ihsan-sa/USB-C-Trigger-Board/Gen1_trigger_boards/USB_C_Trig_Board_Simple_Multi_Layer/USB_C_Simple_Trig_Multi_Layer/3D models/USB4056-03-A.stp

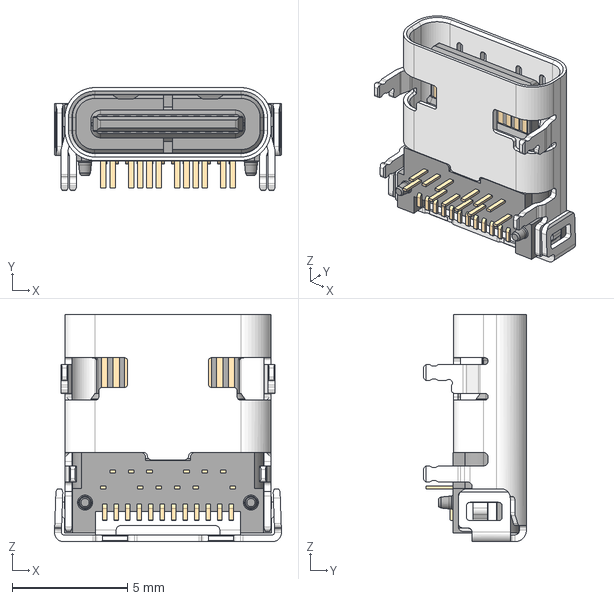
[picture p1: CAD file, 2025-07-22]
Gen1_trigger_boards/USB_C_Trig_Board_Simple_Multi_Layer/USB_C_Simple_Trig_Multi_Layer/3D models/USB4056-03-A.stp
9.85 x 4.46 x 9.87 mm
