ihsan-sa/USB-C-Trigger-Board/Gen1_trigger_boards/USB_C_Trig_Board_Simple/USB_C_Simple_Trig/3D models/CG04874-8M.STEP

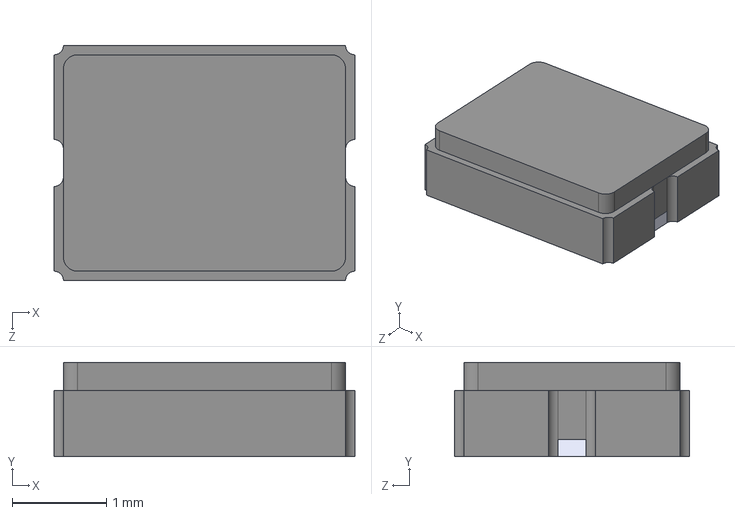
[picture p2: CAD file, 2025-07-22]
Gen1_trigger_boards/USB_C_Trig_Board_Simple/USB_C_Simple_Trig/3D models/CG04874-8M.STEP
3.20 x 1.00 x 2.50 mm
