ihsan-sa/USB-C-Trigger-Board/Gen1_trigger_boards/USB_C_Trig_Board_Simple/USB_C_Simple_Trig/USB_C_Simple_Trig.kicad_pcb

## KiCad design Gen1_trigger_boards/USB_C_Trig_Board_Simple/USB_C_Simple_Trig/USB_C_Simple_Trig.kicad_pcb (2025-09-14)

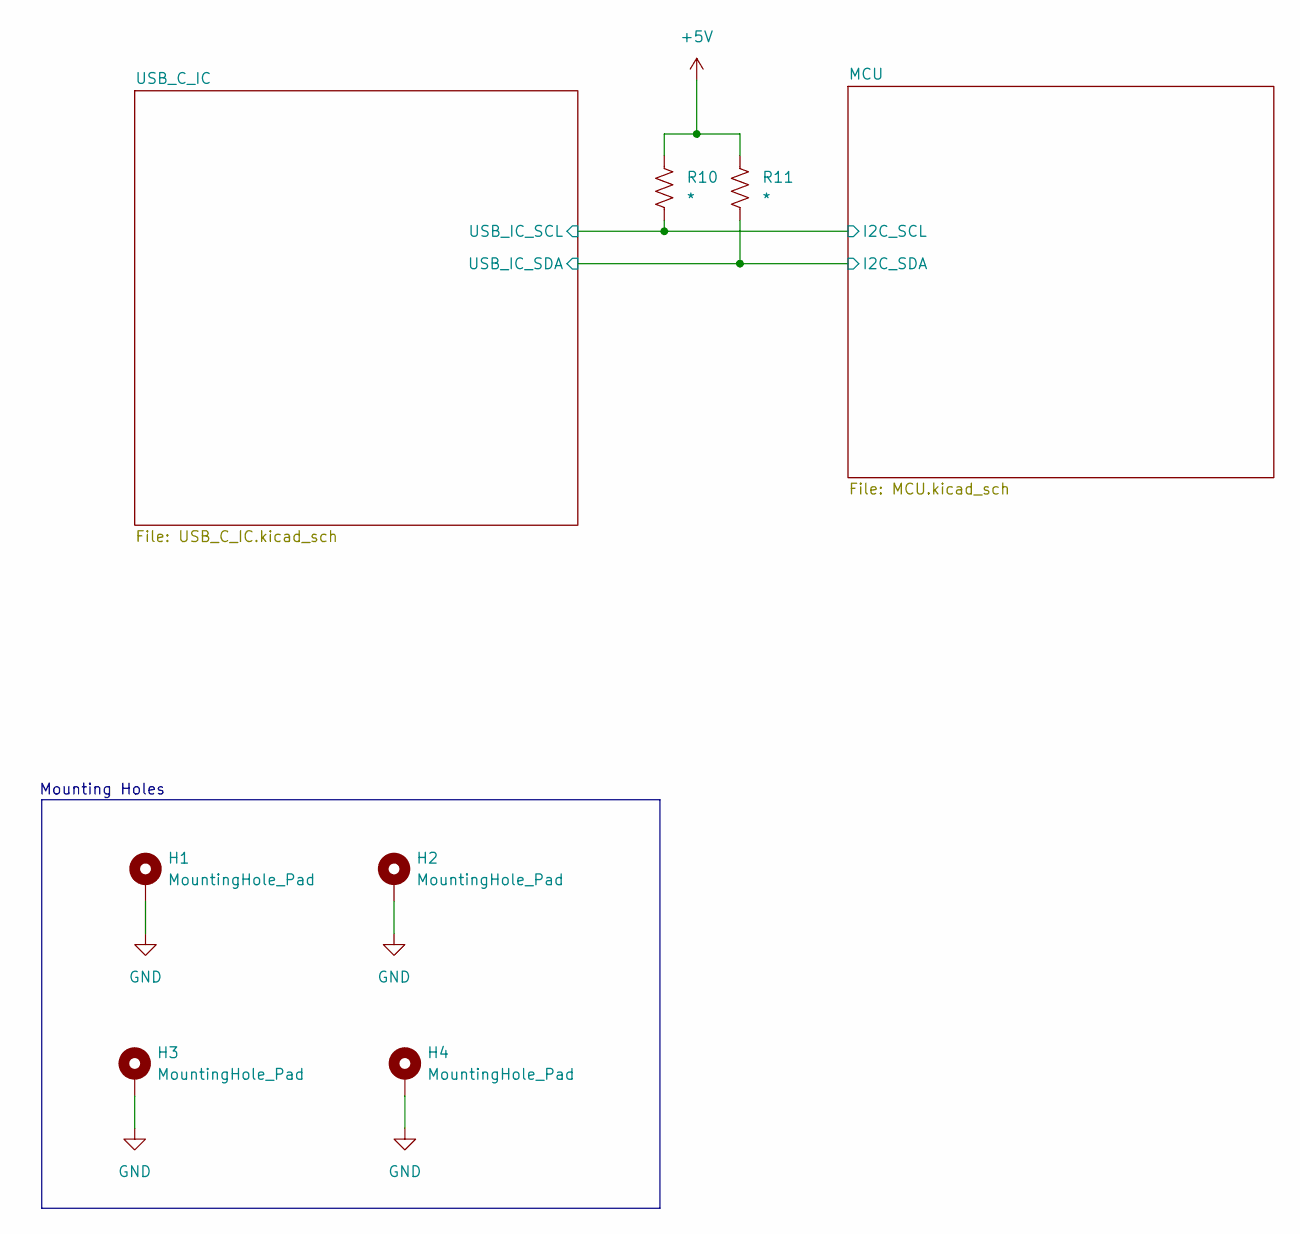
[picture p3: schematic USB_C_Simple_Trig.kicad_sch]

Parts:
H1, H2, H3, H4: MountingHole_Pad; MountingHole_3.2mm_M3_Pad
R10, R11: *; R_0603_1608Metric_Pad0.98x0.95mm_HandSolder

Connections:
+5V: R10.1, R11.1; also elsewhere on the board
/MCU/I2C_SCL: R10.2; also elsewhere on the board
/MCU/I2C_SDA: R11.2; also elsewhere on the board
GND: H1.1, H2.1, H3.1, H4.1; also elsewhere on the board

Notes on the sheet:
Mounting Holes

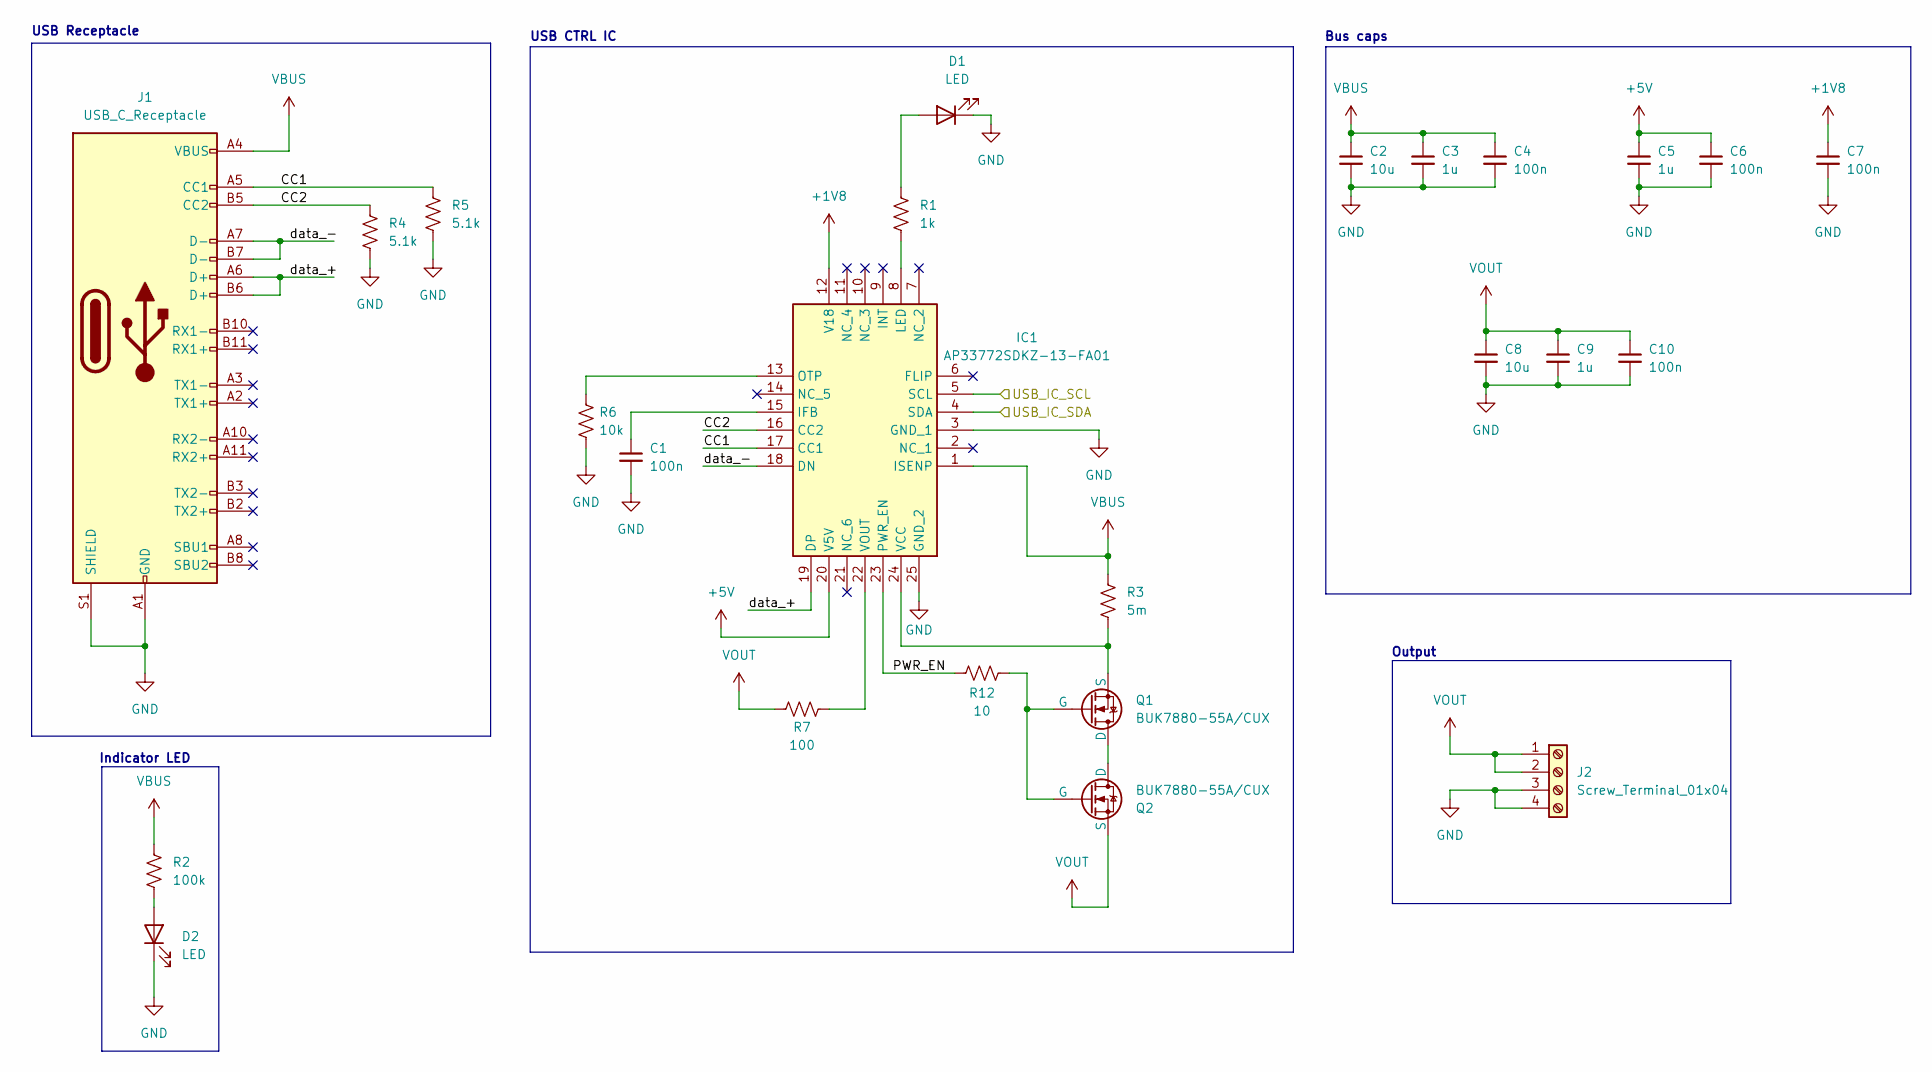
[picture p4: schematic USB_C_IC.kicad_sch]

Parts:
C1, C4, C6, C7, C10: 100n; C_0603_1608Metric_Pad1.08x0.95mm_HandSolder
C2, C8: 10u; C_0603_1608Metric_Pad1.08x0.95mm_HandSolder
C3, C5, C9: 1u; C_0603_1608Metric_Pad1.08x0.95mm_HandSolder
D1, D2: LED; LED_0603_1608Metric_Pad1.05x0.95mm_HandSolder
IC1: AP33772SDKZ-13-FA01; AP33772SDKZ13FA01; Mouser Part Number 621-P33772SDKZ13FA01
J1: USB_C_Receptacle; CONN24_4056-03-A_GCT
J2: Screw_Terminal_01x04; TerminalBlock_Phoenix_MKDS-1,5-4_1x04_P5.00mm_Horizontal
Q1, Q2: BUK7880-55A/CUX; SOT-223-3_TabPin2
R1: 1k; R_0603_1608Metric_Pad0.98x0.95mm_HandSolder
R2: 100k; R_0603_1608Metric_Pad0.98x0.95mm_HandSolder
R3: 5m; R_1206_3216Metric_Pad1.30x1.75mm_HandSolder
R4, R5: 5.1k; R_0603_1608Metric_Pad0.98x0.95mm_HandSolder
R6: 10k; R_0603_1608Metric_Pad0.98x0.95mm_HandSolder
R7: 100; R_0603_1608Metric_Pad0.98x0.95mm_HandSolder
R12: 10; R_0603_1608Metric_Pad0.98x0.95mm_HandSolder

Connections:
+1V8: C7.1, IC1.12 (V18)
+5V: C5.1, C6.1, IC1.20 (V5V); also elsewhere on the board
/MCU/I2C_SCL: IC1.5 (SCL); also elsewhere on the board
/MCU/I2C_SDA: IC1.4 (SDA); also elsewhere on the board
/USB_C_IC/CC1: IC1.17 (CC1), J1.A5 (CC1), R5.2
/USB_C_IC/CC2: IC1.16 (CC2), J1.B5 (CC2), R4.2
/USB_C_IC/PWR_EN: IC1.23 (PWR_EN), R12.2
/USB_C_IC/data_+: IC1.19 (DP), J1.A6 (D+), J1.B6 (D+)
/USB_C_IC/data_-: IC1.18 (DN), J1.A7 (D-), J1.B7 (D-)
GND: C1.2, C2.2, C3.2, C4.2, C5.2, C6.2, C7.2, C8.2, C9.2, C10.2, D1.1 (K), D2.1 (K), IC1.3 (GND_1), IC1.25 (GND_2), J1.A1 (GND), J1.A12 (GND), J1.B1 (GND), J1.B12 (GND), J1.S1 (SHIELD), J2.3, J2.4, R4.1, R5.1, R6.2; also elsewhere on the board
unnamed: D1.2 (A), R1.1
unnamed: D2.2 (A), R2.2
unnamed: C1.1, IC1.15 (IFB)
unnamed: IC1.8 (LED), R1.2
unnamed: IC1.13 (OTP), R6.1
unnamed: IC1.24 (VCC), Q1.3 (S), R3.2
unnamed: IC1.22 (VOUT), R7.1
unnamed: Q1.1 (D), Q2.1 (D)
unnamed: Q1.2 (G), Q2.2 (G), R12.1
VBUS: C2.1, C3.1, C4.1, IC1.1 (ISENP), J1.A4 (VBUS), J1.A9 (VBUS), J1.B4 (VBUS), J1.B9 (VBUS), R2.1, R3.1
VOUT: C8.1, C9.1, C10.1, J2.1, J2.2, Q2.3 (S), R7.2

Notes on the sheet:
Bus caps
Indicator LED
USB Receptacle
Output
USB CTRL IC

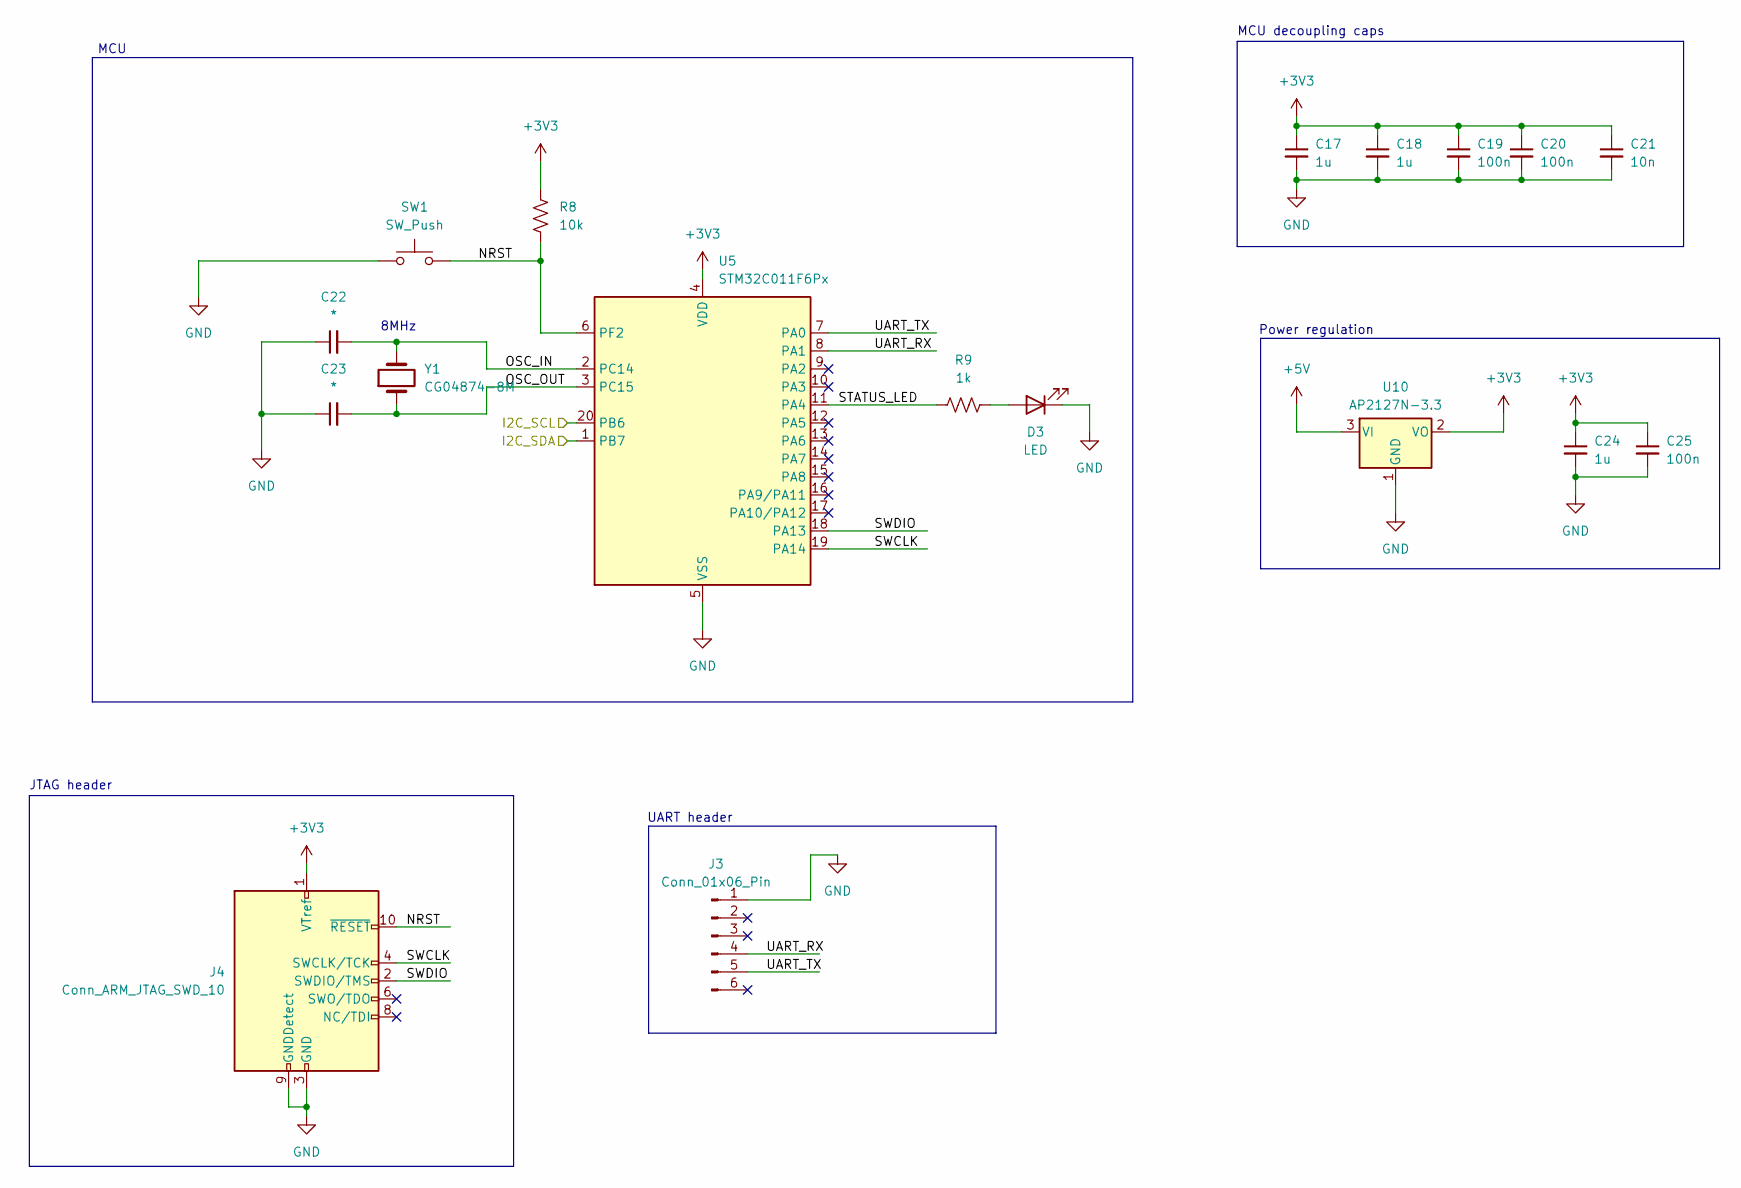
[picture p5: schematic MCU.kicad_sch]

Parts:
C17, C18, C24: 1u; C_0603_1608Metric_Pad1.08x0.95mm_HandSolder
C19, C20, C25: 100n; C_0603_1608Metric_Pad1.08x0.95mm_HandSolder
C21: 10n; C_0603_1608Metric_Pad1.08x0.95mm_HandSolder
C22, C23: *; C_0603_1608Metric_Pad1.08x0.95mm_HandSolder
D3: LED; LED_0603_1608Metric_Pad1.05x0.95mm_HandSolder
J3: Conn_01x06_Pin; PinHeader_1x06_P2.54mm_Vertical
J4: Conn_ARM_JTAG_SWD_10; PinHeader_2x05_P1.27mm_Vertical
R8: 10k; R_0603_1608Metric_Pad0.98x0.95mm_HandSolder
R9: 1k; R_0603_1608Metric_Pad0.98x0.95mm_HandSolder
SW1: SW_Push; SW_PUSH_6mm
U5: STM32C011F6Px; TSSOP-20_4.4x6.5mm_P0.65mm
U10: AP2127N-3.3; SOT-23
Y1: CG04874-8M; XTAL_CG04874_NDK

Connections:
+3V3: C17.1, C18.1, C19.1, C20.1, C21.1, C24.1, C25.1, J4.1 (VTref), R8.1, U5.4 (VDD), U10.2 (VO)
+5V: U10.3 (VI); also elsewhere on the board
/MCU/I2C_SCL: U5.20 (PB6); also elsewhere on the board
/MCU/I2C_SDA: U5.1 (PB7); also elsewhere on the board
/MCU/NRST: J4.10 (~RESET), R8.2, SW1.2, U5.6 (PF2)
/MCU/OSC_IN: C22.2, U5.2 (PC14), Y1.2
/MCU/OSC_OUT: C23.2, U5.3 (PC15), Y1.1
/MCU/STATUS_LED: R9.2, U5.11 (PA4)
/MCU/SWCLK: J4.4 (SWCLK/TCK), U5.19 (PA14)
/MCU/SWDIO: J4.2 (SWDIO/TMS), U5.18 (PA13)
/MCU/UART_RX: J3.4, U5.8 (PA1)
/MCU/UART_TX: J3.5, U5.7 (PA0)
GND: C17.2, C18.2, C19.2, C20.2, C21.2, C22.1, C23.1, C24.2, C25.2, D3.1 (K), J3.1, J4.3 (GND), J4.5 (GND), J4.9 (GNDDetect), SW1.1, U5.5 (VSS), U10.1 (GND); also elsewhere on the board
unnamed: D3.2 (A), R9.1

Notes on the sheet:
JTAG header
UART header
8MHz
MCU decoupling caps
MCU
Power regulation

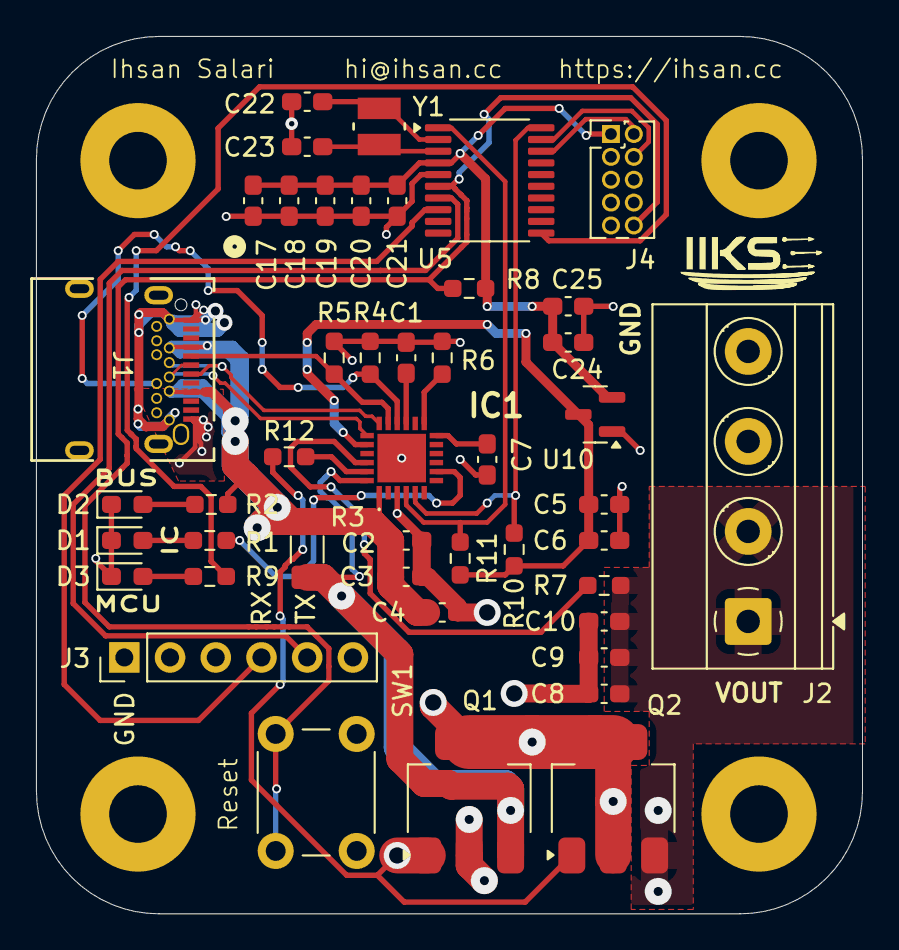
[picture p6: board USB_C_Simple_Trig.kicad_pcb from above]

Board: 2 copper layers, 45.9 x 48.7 mm, 49 parts (0 on the bottom side), 31 nets.
