ihsan-sa/USB-C-Trigger-Board/Gen1_trigger_boards/FW/Core/Src/main.c

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
/* Includes ------------------------------------------------------------------*/
#include "main.h"

/* USER CODE BEGIN Includes */
#include "AP33772S.h"
#include "uix.h"
#include <stdio.h>
#include <stdbool.h>
/* USER CODE END Includes */


I2C_HandleTypeDef hi2c1;

TIM_HandleTypeDef htim14;

UART_HandleTypeDef huart1;

void SystemClock_Config(void);
static void MX_GPIO_Init(void);
static void MX_I2C1_Init(void);
static void MX_USART1_UART_Init(void);
static void MX_TIM14_Init(void);
/* USER CODE BEGIN 0 */
int _write(int file, char *data, int len) {
	HAL_UART_Transmit(&huart1, (uint8_t*) data, len, HAL_MAX_DELAY);
	return len;
}

void menu_exit_delay(uint8_t * const uart_buff){
	printf("\n\r--press any key to exit--\r\n");

	*uart_buff = '\0';
	while(*uart_buff == '\0'){
		*uart_buff = '\0';
		HAL_UART_Receive_IT(&huart1, uart_buff, 1);
	}
	*uart_buff = '\0';
}


/* USER CODE END 0 */

/**
  * @brief  The application entry point.
  * @retval int
  */
int main(void)
{

  /* MCU Configuration--------------------------------------------------------*/

  /* Reset of all peripherals, Initializes the Flash interface and the Systick. */
  HAL_Init();

  /* Configure the system clock */
  SystemClock_Config();

  /* Initialize all configured peripherals */
  MX_GPIO_Init();
  MX_I2C1_Init();
  MX_USART1_UART_Init();
  MX_TIM14_Init();
  /* USER CODE BEGIN 2 */

  //init PWM
  HAL_TIM_PWM_Start(&htim14, TIM_CHANNEL_1);

  printf("\n\rStarting...\n\r");
  HAL_Delay(500);
  set_default_voltage();
  printf("Init complete.\r\n");
  uint32_t start = HAL_GetTick();
  bool retry = 0;
  //UART buff
  char uart_buff = '\0';
  HAL_UART_Receive_IT(&huart1, &uart_buff, 1);


  /* USER CODE END 2 */

  /* Infinite loop */
  /* USER CODE BEGIN WHILE */
  while (1)
  {
	 if(retry == 0 && (HAL_GetTick() - start) > 2000){
//		 printf("retry\r\n");
		 set_default_voltage();
		 retry = 1;
	 }
	 print_stats();
	 HAL_UART_Receive_IT(&huart1, &uart_buff, 1);

	 if(uart_buff != '\0'){
		 HAL_UART_Transmit(&huart1, &uart_buff, 1, HAL_MAX_DELAY); //echo
		 if(uart_buff == 's'){
			 req_PDO_options();

			 printf("\r\nSelect PDO and hit enter.\r\n");

			 uint8_t pdo = get_user_input();
			 printf("\r\nSelect current limit:\r\n\t0\t1.00A\r\n\t1\t1.25A\r\n\t2\t1.50A\r\n\t3\t1.75A\r\n\t4\t2.00A\r\n\t5\t2.25A\r\n\t6\t2.50A\r\n\t7\t2.75A\r\n\t8\t3.00A\r\n\t9\t3.25A\r\n\t10\t3.50A\r\n\t11\t3.75A\r\n\t12\t4.00A\r\n\t13\t4.25A\r\n\t14\t4.50A\r\n\t15\t5.00A\r\n\r\n");

			 uint8_t curr = get_user_input();
			 select_PDO(pdo, curr);

			 menu_exit_delay(&uart_buff);
		 }
		 if(uart_buff == 'c'){
			 req_PDO_options();

			 menu_exit_delay(&uart_buff);
		 }
		 if(uart_buff == 'h'){
			 printf("\r\n\r\n*****************HELP MENU*****************\r\n\r\n");
			 printf("Commands:\r\n");
			 printf("\tc\tlist all the available PDOs\r\n");
			 printf("\ts\tlist all the available PDOs and select new PDO\r\n");
			 printf("\th\thelp\r\n");

			 menu_exit_delay(&uart_buff);
		 }
	 }

    /* USER CODE END WHILE */

    /* USER CODE BEGIN 3 */
  }
  /* USER CODE END 3 */
}

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
