ihsan-sa/USB-C-Trigger-Board/Gen1_trigger_boards/FW/USB_C_Light_Simple_FW.ioc

Mcu.UserName=STM32C011F6Px
PA0.Signal=USART1_TX
PA1.Signal=USART1_RX
PA13.Signal=DEBUG_SWDIO
PA14-BOOT0.Signal=DEBUG_SWCLK
PA4.Signal=S_TIM14_CH1
PB6.Signal=I2C1_SCL
PB7.Signal=I2C1_SDA
