ihsan-sa/USB-C-Trigger-Board/(commit log)

2025-07-13 Fleshed out high level overview and created and nearly completed USB IC schematic.
    [MCU.kicad_sch, USBC_trigger_board.kicad_pcb, USBC_trigger_board.kicad_sch, USB_C.kicad_sch, boost_converter.kicad_sch, buck_boost.kicad_sch, buck_boost_converter.kicad_sch, buck_converter.kicad_sch]
2025-07-22 Simple trigger board: placed all the components. Next step: route
    [CG04874-8M.STEP, MCU.kicad_sch, USB4056-03-A.stp, USBC_trigger_board.kicad_pcb, USBC_trigger_board.kicad_sch, USB_C.kicad_sch, USB_C_IC.kicad_sch, USB_C_Simple_Trig.kicad_pcb]
2025-07-24 Simple trigger board: finished draft PCB routing
    [USB_C_Simple_Trig-B_Cu.gbr, USB_C_Simple_Trig-B_Mask.gbr, USB_C_Simple_Trig-B_Paste.gbr, USB_C_Simple_Trig-B_Silkscreen.gbr, USB_C_Simple_Trig-Edge_Cuts.gbr, USB_C_Simple_Trig-F_Cu.gbr, USB_C_Simple_Trig-F_Mask.gbr, USB_C_Simple_Trig-F_Paste.gbr]
2025-08-16 USB-C Multi-layer SimpleTrig
    Created project and completed first version of multi-layer setup.
    [CG04874-8M.STEP, MCU.kicad_sch, USB4056-03-A.stp, USB_C_IC.kicad_sch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]
2025-08-16 Simple 2-Layer Trig:
    Rerouted power traces and added some high current copper pour on ground plane.
    [USB_C_Simple_Trig.kicad_pcb]
2025-08-16 Silkscreen update for both simple trig boards.
    [USB_C_Simple_Trig.kicad_pcb]
2025-08-19 ordered v1
    [USB_C_Simple_Trig-B_Cu.gbr, USB_C_Simple_Trig-B_Mask.gbr, USB_C_Simple_Trig-B_Paste.gbr, USB_C_Simple_Trig-B_Silkscreen.gbr, USB_C_Simple_Trig-Edge_Cuts.gbr, USB_C_Simple_Trig-F_Cu.gbr, USB_C_Simple_Trig-F_Mask.gbr, USB_C_Simple_Trig-F_Paste.gbr]
2025-09-14 Created folder for Gen1 trigger boards
2025-09-14 Moved trigger boards to new folder
    [CG04874-8M.STEP, MCU.kicad_sch, USB4056-03-A.stp, USB_C_IC.kicad_sch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]
