ihsan-sa/USB-C-Trigger-Board/(notices)

Notices in the files:
Gen1_trigger_boards/FW/Core/Src/main.c:
Copyright (c) 2025 STMicroelectronics.
All rights reserved.
This software is licensed under terms that can be found in the LICENSE file
Gen1_trigger_boards/USB_C_Trig_Board_Simple/USB_C_Simple_Trig/3D models/USB4056-03-A.stp:
author */ ('License CC BY-ND 4.0'),
